blurbler2/powerboard/powerboard-docs/powerboard-v1-bottom.png

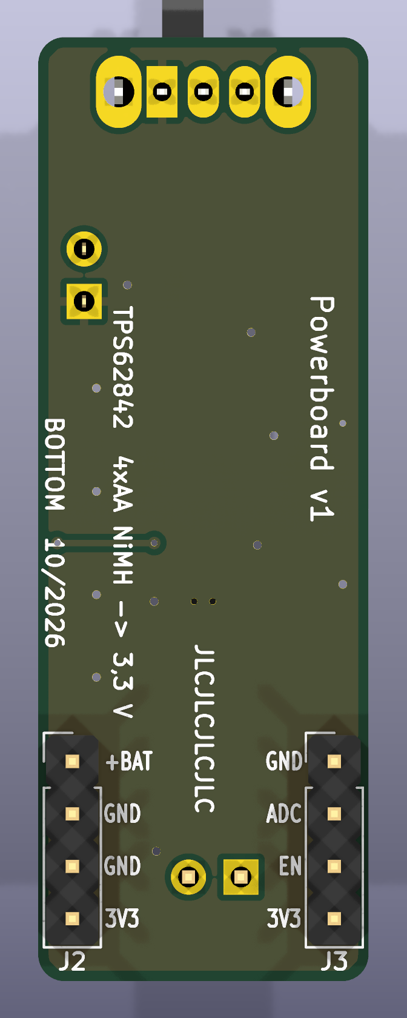
powerboard-docs/powerboard-v1-bottom.png
