blurbler2/powerboard/powerboard-docs/powerboard-v1-schematic.png

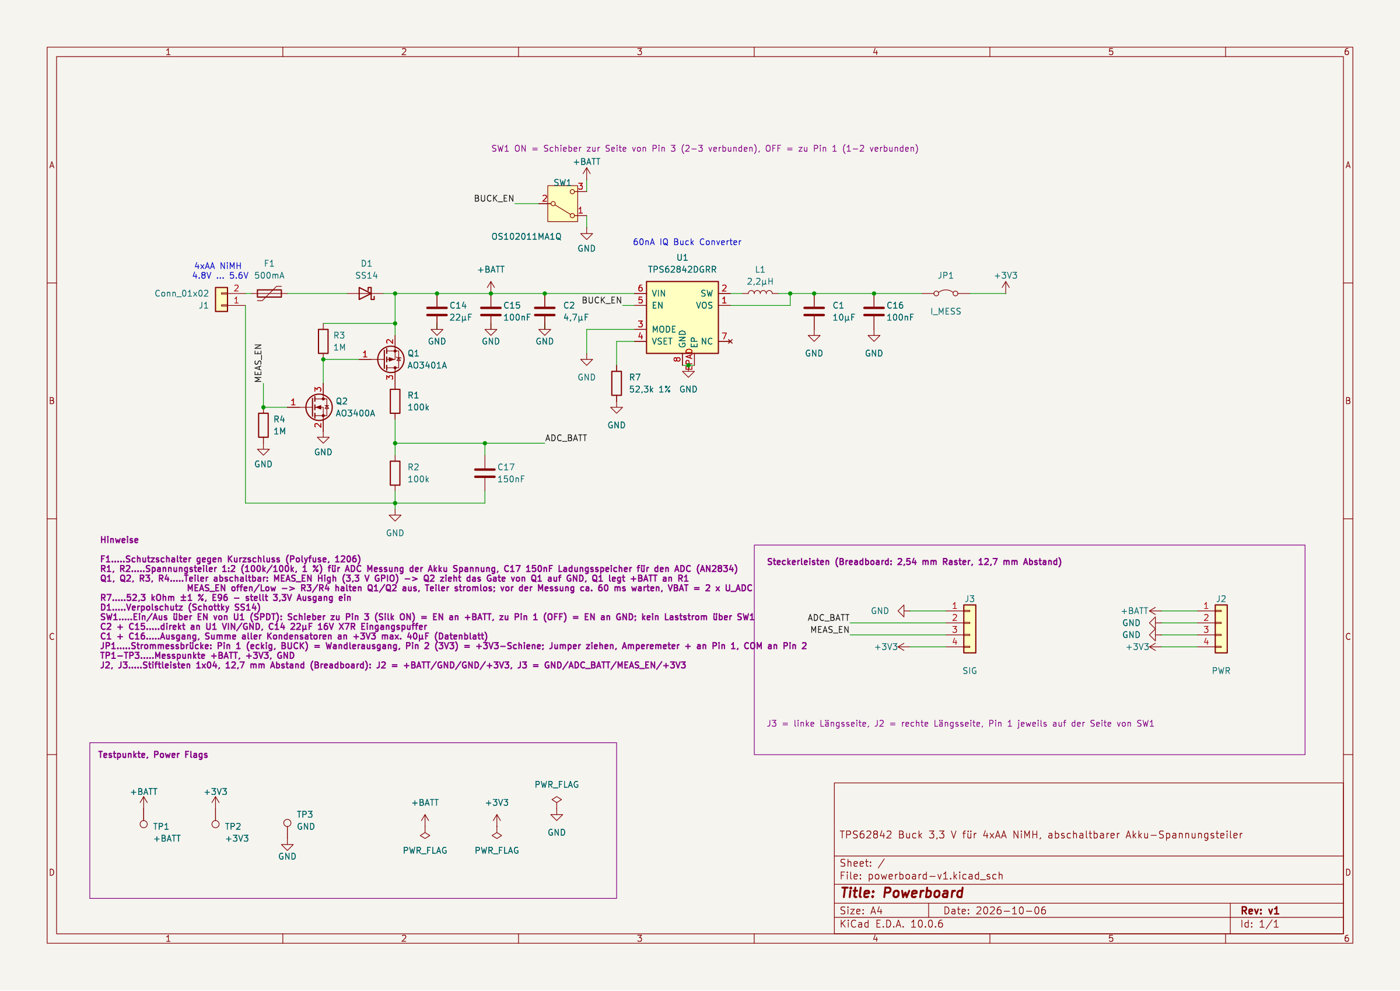
powerboard-docs/powerboard-v1-schematic.png
