blurbler2/powerboard/powerboard-docs/powerboard-v1-top.png

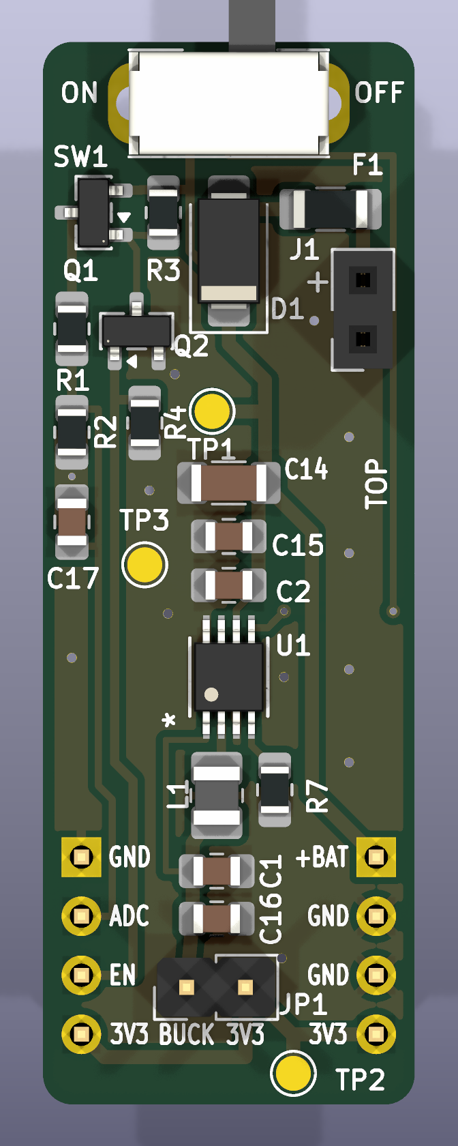
powerboard-docs/powerboard-v1-top.png
