blurbler2/powerboard/powerboard-hw/powerboard-v1/bom/powerboard-v1-bom.csv

Refs | Value | Footprint | Qty | Datasheet | Description
C1 | 10µF | Capacitor_SMD:C_0805_2012Metric_Pad1.18x1.45mm_HandSolder | 1 |  | Unpolarized capacitor
C2 | 4,7µF | Capacitor_SMD:C_0805_2012Metric_Pad1.18x1.45mm_HandSolder | 1 |  | Unpolarized capacitor
C14 | 22µF | Capacitor_SMD:C_1206_3216Metric_Pad1.33x1.80mm_HandSolder | 1 |  | Unpolarized capacitor
C15,C16 | 100nF | Capacitor_SMD:C_0805_2012Metric_Pad1.18x1.45mm_HandSolder | 2 |  | Unpolarized capacitor
C17 | 150nF | Capacitor_SMD:C_0805_2012Metric_Pad1.18x1.45mm_HandSolder | 1 |  | Unpolarized capacitor
D1 | SS14 | Diode_SMD:D_SMA | 1 | https://www.vishay.com/docs/88746/ss12.pdf | 40V 1A Schottky Barrier Rectifier Diode, SMA(DO-214AC)
F1 | 500mA | Fuse:Fuse_1206_3216Metric_Pad1.42x1.75mm_HandSolder | 1 |  | Resettable fuse, polymeric positive temperature coefficient
J1 | Conn_01x02 | Connector_PinSocket_2.54mm:PinSocket_1x02_P2.54mm_Vertical | 1 |  | Generic connector, single row, 01x02, script generated (kicad-library-utils/schlib/autogen/connector/)
J2 | PWR | Connector_PinHeader_2.54mm:PinHeader_1x04_P2.54mm_Vertical | 1 | ~ | Generic connector, single row, 01x04, script generated (kicad-library-utils/schlib/autogen/connector/)
J3 | SIG | Connector_PinHeader_2.54mm:PinHeader_1x04_P2.54mm_Vertical | 1 | ~ | Generic connector, single row, 01x04, script generated (kicad-library-utils/schlib/autogen/connector/)
JP1 | I_MESS | Connector_PinHeader_2.54mm:PinHeader_1x02_P2.54mm_Vertical | 1 |  | Jumper, 2-pole, closed/bridged
L1 | 2,2µH | Inductor_SMD:L_1008_2520Metric_Pad1.43x2.20mm_HandSolder | 1 |  | Inductor
Q1 | AO3401A | Package_TO_SOT_SMD:SOT-23 | 1 | http://www.aosmd.com/pdfs/datasheet/AO3401A.pdf | -4.0A Id, -30V Vds, P-Channel MOSFET, SOT-23
Q2 | AO3400A | Package_TO_SOT_SMD:SOT-23 | 1 | http://www.aosmd.com/pdfs/datasheet/AO3400A.pdf | 30V Vds, 5.7A Id, N-Channel MOSFET, SOT-23
R1,R2 | 100k | Resistor_SMD:R_0805_2012Metric_Pad1.20x1.40mm_HandSolder | 2 |  | Resistor
R3,R4 | 1M | Resistor_SMD:R_0805_2012Metric_Pad1.20x1.40mm_HandSolder | 2 | ~ | Resistor
R7 | 52,3k 1% | Resistor_SMD:R_0805_2012Metric_Pad1.20x1.40mm_HandSolder | 1 |  | Resistor
SW1 | OS102011MA1Q | Button_Switch_THT:SW_Slide_SPDT_Angled_CK_OS102011MA1Q | 1 | ~ | Switch, single pole double throw
TP1 | +BATT | TestPoint:TestPoint_Pad_D1.5mm | 1 |  | test point
TP2 | +3V3 | TestPoint:TestPoint_Pad_D1.5mm | 1 |  | test point
TP3 | GND | TestPoint:TestPoint_Pad_D1.5mm | 1 |  | test point
U1 | TPS62842DGRR | powerboard:VSSOP_42DGRR_TEX-L | 1 | https://www.ti.com/lit/ds/symlink/tps62840.pdf | TPS6284x 750 mA step-down converter, 60 nA Iq, HVSSOP-8 (DGR). VOUT set by RSET on VSET (52.3k = 3.3 V); EN max 6.5 V; output capacitance 3-40 uF effective.
