blurbler2/powerboard/powerboard-hw/powerboard-v1/powerboard-v1.kicad_pcb

## KiCad design powerboard-hw/powerboard-v1/powerboard-v1.kicad_pcb (2026-10-07)

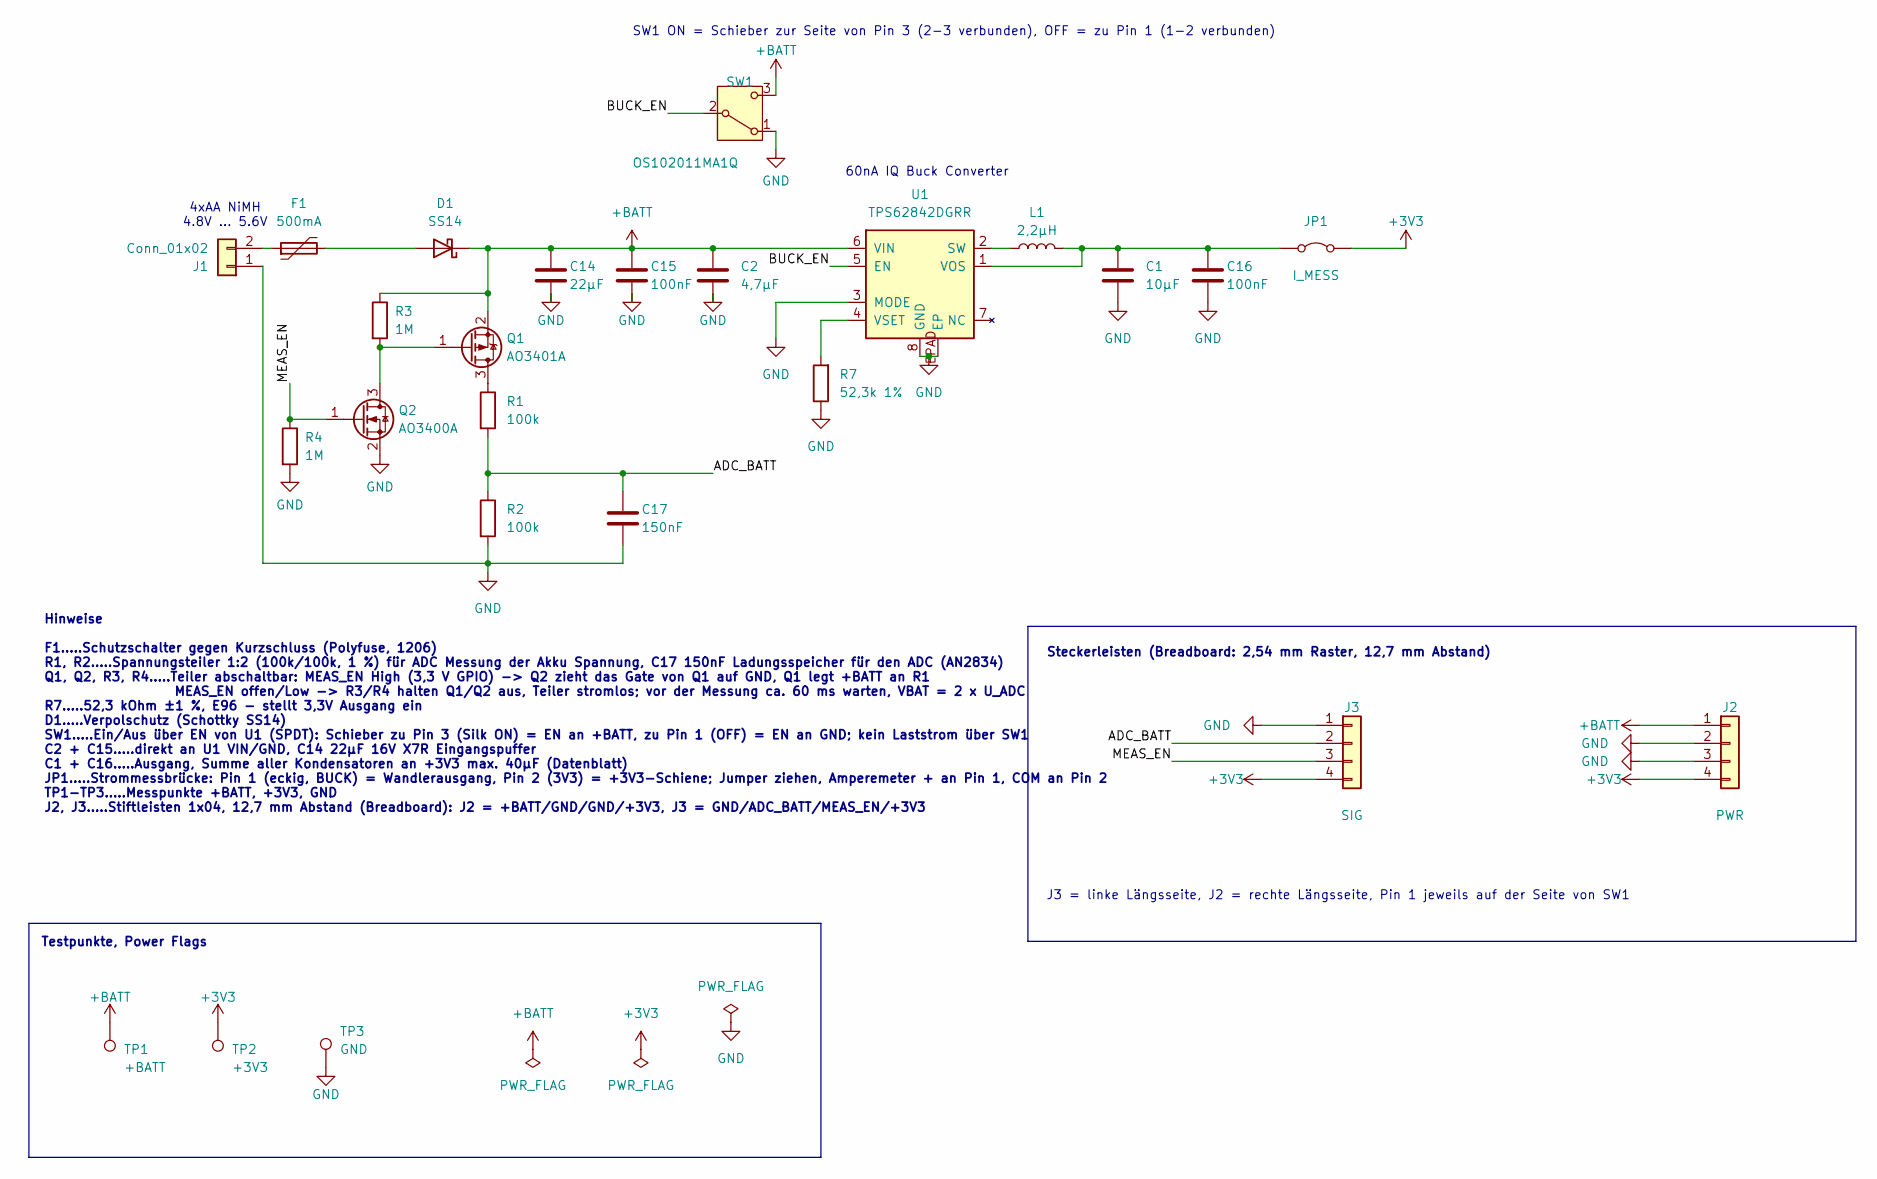
[picture p7: schematic powerboard-v1.kicad_sch, Powerboard]

Parts:
C1: 10µF; C_0805_2012Metric_Pad1.18x1.45mm_HandSolder
C2: 4,7µF; C_0805_2012Metric_Pad1.18x1.45mm_HandSolder
C14: 22µF; C_1206_3216Metric_Pad1.33x1.80mm_HandSolder
C15, C16: 100nF; C_0805_2012Metric_Pad1.18x1.45mm_HandSolder
C17: 150nF; C_0805_2012Metric_Pad1.18x1.45mm_HandSolder
D1: SS14; D_SMA
F1: 500mA; Fuse_1206_3216Metric_Pad1.42x1.75mm_HandSolder
J1: Conn_01x02; PinSocket_1x02_P2.54mm_Vertical
J2: PWR; PinHeader_1x04_P2.54mm_Vertical
J3: SIG; PinHeader_1x04_P2.54mm_Vertical
JP1: I_MESS; PinHeader_1x02_P2.54mm_Vertical
L1: 2,2µH; L_1008_2520Metric_Pad1.43x2.20mm_HandSolder
Q1: AO3401A; SOT-23
Q2: AO3400A; SOT-23
R1, R2: 100k; R_0805_2012Metric_Pad1.20x1.40mm_HandSolder
R3, R4: 1M; R_0805_2012Metric_Pad1.20x1.40mm_HandSolder
R7: 52,3k 1%; R_0805_2012Metric_Pad1.20x1.40mm_HandSolder
SW1: OS102011MA1Q; SW_Slide_SPDT_Angled_CK_OS102011MA1Q
TP1: +BATT; TestPoint_Pad_D1.5mm
TP2: +3V3; TestPoint_Pad_D1.5mm
TP3: GND; TestPoint_Pad_D1.5mm
U1: TPS62842DGRR; VSSOP_42DGRR_TEX-L

Connections:
+3V3: J2.4, J3.4, JP1.2 (B), TP2.1
+BATT: C2.1, C14.1, C15.1, D1.1 (K), J2.1, Q1.2 (S), R3.1, SW1.3 (C), TP1.1, U1.6 (VIN)
/ADC_BATT: C17.1, J3.2, R1.2, R2.1
/BUCK_EN: SW1.2 (B), U1.5 (EN)
/MEAS_EN: J3.3, Q2.1 (G), R4.1
GND: C1.1, C2.2, C14.2, C15.2, C16.2, C17.2, J1.1, J2.2, J2.3, J3.1, Q2.2 (S), R2.2, R4.2, R7.1, SW1.1 (A), TP3.1, U1.3 (MODE), U1.8 (GND), U1.EPAD (EP)
unnamed: D1.2 (A), F1.2
unnamed: F1.1, J1.2
unnamed: C1.2, C16.1, JP1.1 (A), L1.2, U1.1 (VOS)
unnamed: Q1.3 (D), R1.1
unnamed: Q1.1 (G), Q2.3 (D), R3.2
unnamed: L1.1, U1.2 (SW)
unnamed: R7.2, U1.4 (VSET)

Notes on the sheet:
60nA IQ Buck Converter
Testpunkte, Power Flags
Hinweise F1.....Schutzschalter gegen Kurzschluss (Polyfuse, 1206) R1, R2.....Spannungsteiler 1:2 (100k/100k, 1 %) für ADC Messung der Akku Spannung, C17 150nF Ladungsspeicher für den ADC (AN2834) Q1, Q2, R3, R4.....Teiler abschaltbar: MEAS_EN High (3,3 V GPIO) -> Q2 zieht das Gate von Q1 auf GND, Q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
4xAA NiMH 4.8V ... 5.6V
SW1 ON = Schieber zur Seite von Pin 3 (2-3 verbunden), OFF = zu Pin 1 (1-2 verbunden)
Steckerleisten (Breadboard: 2,54 mm Raster, 12,7 mm Abstand)
J3 = linke Längsseite, J2 = rechte Längsseite, Pin 1 jeweils auf der Seite von SW1

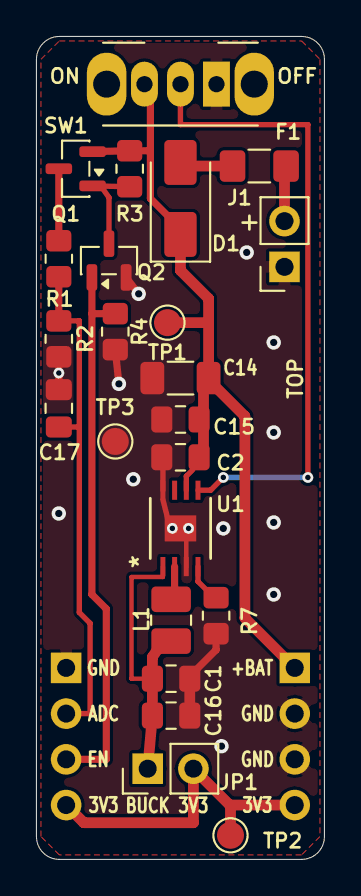
[picture p8: board powerboard-v1.kicad_pcb from above]

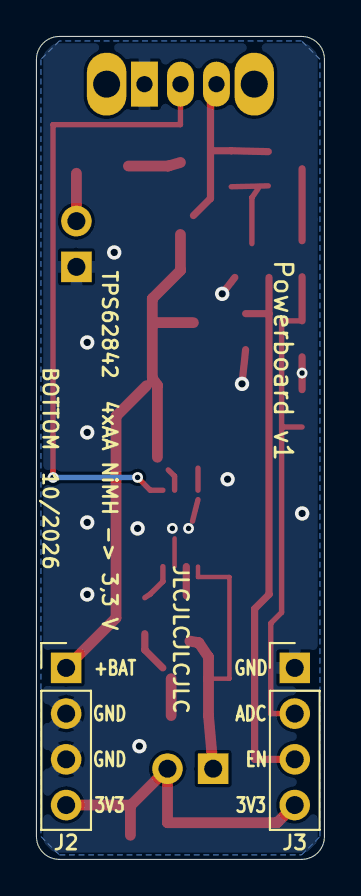
[picture p9: board powerboard-v1.kicad_pcb from below]

Board: 2 copper layers, 16.0 x 45.7 mm, 25 parts (2 on the bottom side), 13 nets.
