blurbler2/powerboard/(commit log)

2026-10-07 feat: powerboard v1, TPS62842 3.3 V module in olmBoard format
    KiCad 10 project for a 4x AA NiMH to 3.3 V buck module, laid out like
    olmBoard (powerboard-hw/, powerboard-lib/, powerboard-docs/).
    Schematic
    - J1 battery input, F1 500 mA polyfuse, SW1 slide switch, D1 SS14
    reverse-polarity diode, TPS62842 at 3.3 V (R7 52.3k), JP1 current
    jumper between converter output and +3V3, test points TP1-TP3.
    - Switchable battery divider: R1/R2 1M/1M with C17 150 nF, Q1 AO3401A
    (P-ch) high-side switch, Q2 AO3400A (N-ch) level shifter from a 3.3 V
    GPIO, R3/R4 1M keep both off. Divider is off (0 V at the ADC pin)
    unless MEAS_EN is driven high.
    - Pin headers: J2 PWR = +BATT, GND, GND, +3V3 (olmBoa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
2026-10-07 fix: JLCPCB-ready silkscreen and ordering notes
    - Silkscreen text stroke 0.12 -> 0.15 mm (JLCPCB minimum line width).
    - JLCJLCJLCJLC placeholder on the bottom for the order number.
    - JP1 labels BUCK / 3V3 on the top only (bottom copy ran into J3's label).
    - README: JLCPCB order settings, assembly and first power-up checklist,
    output capacitance limit (3 ... 40 uF effective) for the load.
    - Regenerated Gerbers, drill, position file and images.
    ERC: 0. DRC: 0 violations, 0 unconnected, schematic parity OK.
2026-10-07 fix: SW1 switches the converter enable instead of the battery line
    SW1 (C&K OS102011MA1Q) is rated 100 mA and sat in series with the
    battery, which limited the module to about 120 mA. It now drives the
    TPS62842 EN pin (net BUCK_EN): middle pin to EN, left pin to +BATT,
    right pin to GND. Only the EN input current flows through it; the load
    current goes J1 -> F1 -> D1 -> converter. F1 (500 mA hold) is now the
    lowest limit, about 600 mA at 3.3 V.
    ON/OFF direction from the C&K OS series datasheet (position 1 = 1-2,
    position 2 = 2-3: the slider connects the middle pin to the outer pin
    on its side): slider left = 2-3 = ON, slider right = 1-2 = OFF, printed
    as ON / OFF at the two ends of the switc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
2026-10-07 fix: battery divider R1/R2 100k instead of 1M
    The divider is switched off by Q1 between measurements, so it no longer
    needs megaohm values. With 100k/100k the settling of C17 (150 nF)
    drops from tau = 75 ms to 7.5 ms: about 65 ms before the ADC reading
    instead of 0.6 s. Current while measuring is about 37 uA, the charge
    per measurement is lower than before (about 4 uC vs 7 uC).
    R3/R4 stay 1M. Board geometry unchanged (tracks, vias, pads, silk,
    fills identical); only the values in schematic, BOM, position file and
    Gerber attributes change. Schematic notes and README timing updated.
    ERC: 0. DRC: 0 violations, 0 unconnected, schematic parity OK.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
